SyntaxGitRepo/Fischklappe-v2/3D-modelle/Fischklappe_Klappe.stl

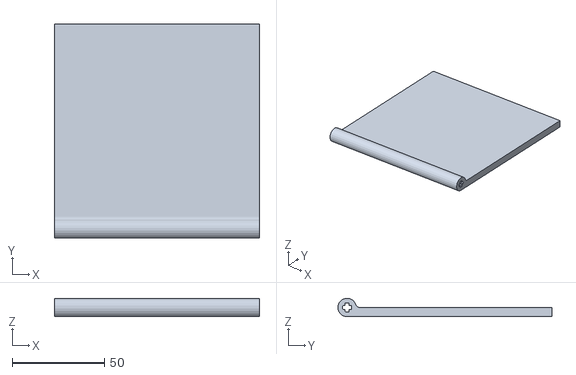
[picture p2: CAD file, 2025-11-01]
3D-modelle/Fischklappe_Klappe.stl
111.0 x 116.0 x 9.97
