SyntaxGitRepo/Fischklappe-v2/3D-modelle/Fischklappe_Base.stl

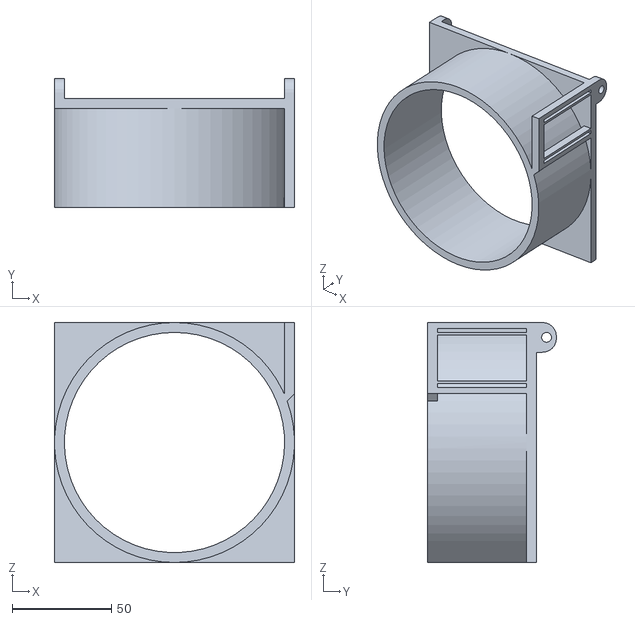
[picture p3: CAD file, 2025-11-01]
3D-modelle/Fischklappe_Base.stl
121.0 x 65.0 x 121.0
