SyntaxGitRepo/Fischklappe-v2/3D-modelle/Fischklappe_Stuetze.stl

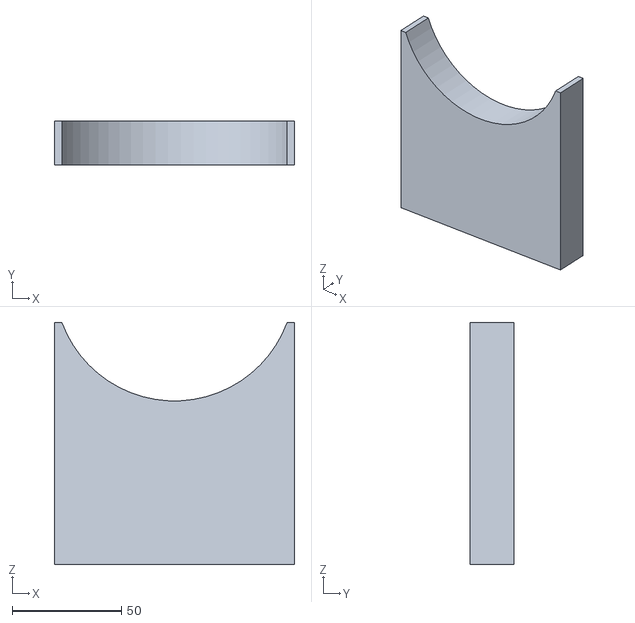
[picture p4: CAD file, 2025-11-01]
3D-modelle/Fischklappe_Stuetze.stl
110.0 x 20.0 x 111.0
