SyntaxGitRepo/Fischklappe-v2/3D-modelle/Fischklappe_Halterung.stl

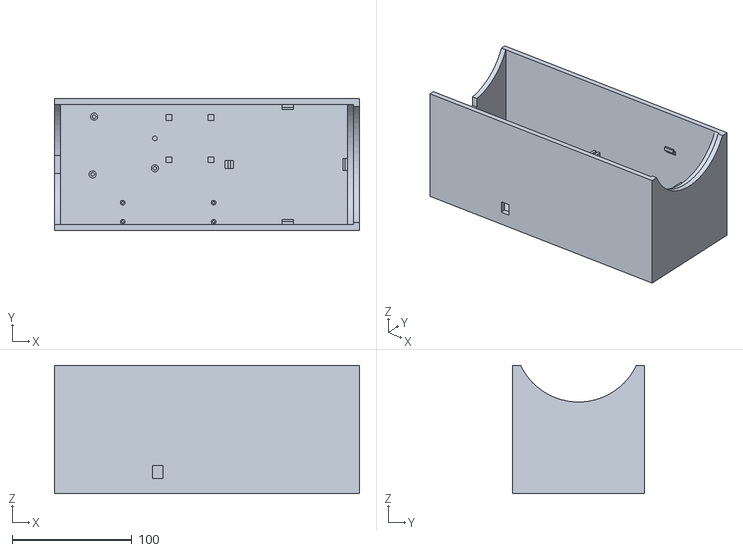
[picture p5: CAD file, 2025-11-01]
3D-modelle/Fischklappe_Halterung.stl
255.0 x 110.0 x 107.1
