SyntaxGitRepo/Fischklappe-v2/Fischklappe Schaltbild.pdf

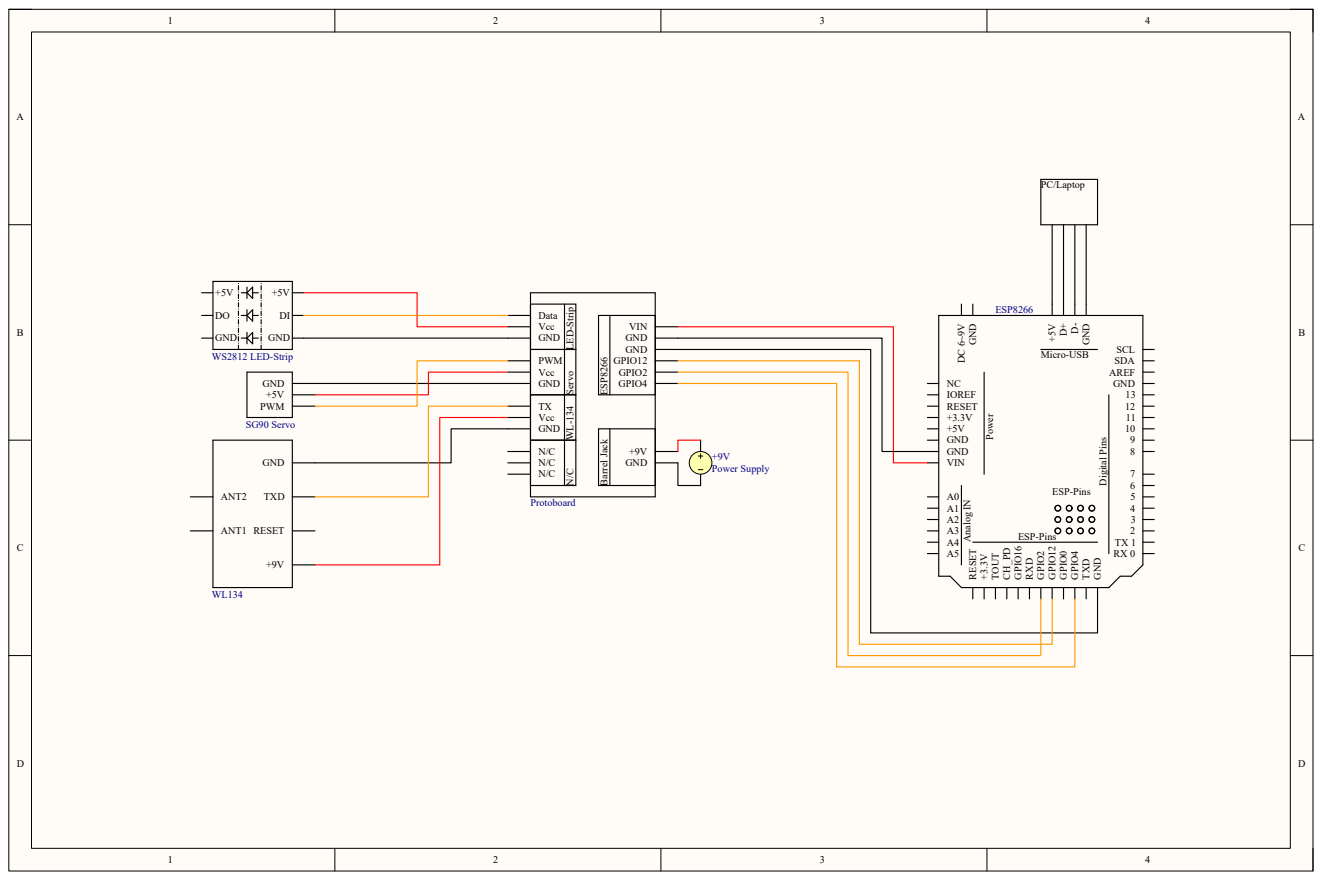
[picture p6: page 1]
GND; RESET; IOREF; VIN; Power; AREF; SDA; SCL DC ⁶~9V GND; GNDD⁺D⁻ +⁵V; Digital Pins; ESP-Pins; ESP8266; PWM; SG90 Servo; WS2812 LED-Strip; PC/Laptop; Data Vcc GND; PWM Vcc GND; TX Vcc GND; VIN GND GND GPIO12 GPIO2 GPIO4; GND LED⁻Strip Servo WL⁻¹³⁴ N/C; ESP⁸²⁶⁶ Barrel Jack; Protoboard; TXD; ANT1; ANT2; +9V Power Supply

Micro-USB RESET

ESP-Pins +³.3V TOUT CH_PD GPIO¹⁶ RXD GPIO² GPIO¹² GPIO⁰ GPIO⁴ TXD GND
A5 Analog IN
