SyntaxGitRepo/Fischklappe-v2/(commit log)

2025-02-27 added schematic pdf
2025-02-27 new Schematic
2025-11-01 added 3D-modelle: Fischklappe Halterung und Stütze
    [Fischklappe Halterung.stl, Fischklappe Stuetze.stl]
2025-11-01 added 3D-modelle: Fischklappe Base und Klappe
    [Fischklappe_Base.stl, Fischklappe_Halterung.stl, Fischklappe_Klappe.stl, Fischklappe_Stuetze.stl]
